sprieton/Feeder4pets/blueprint/Feeder4pets.pdf

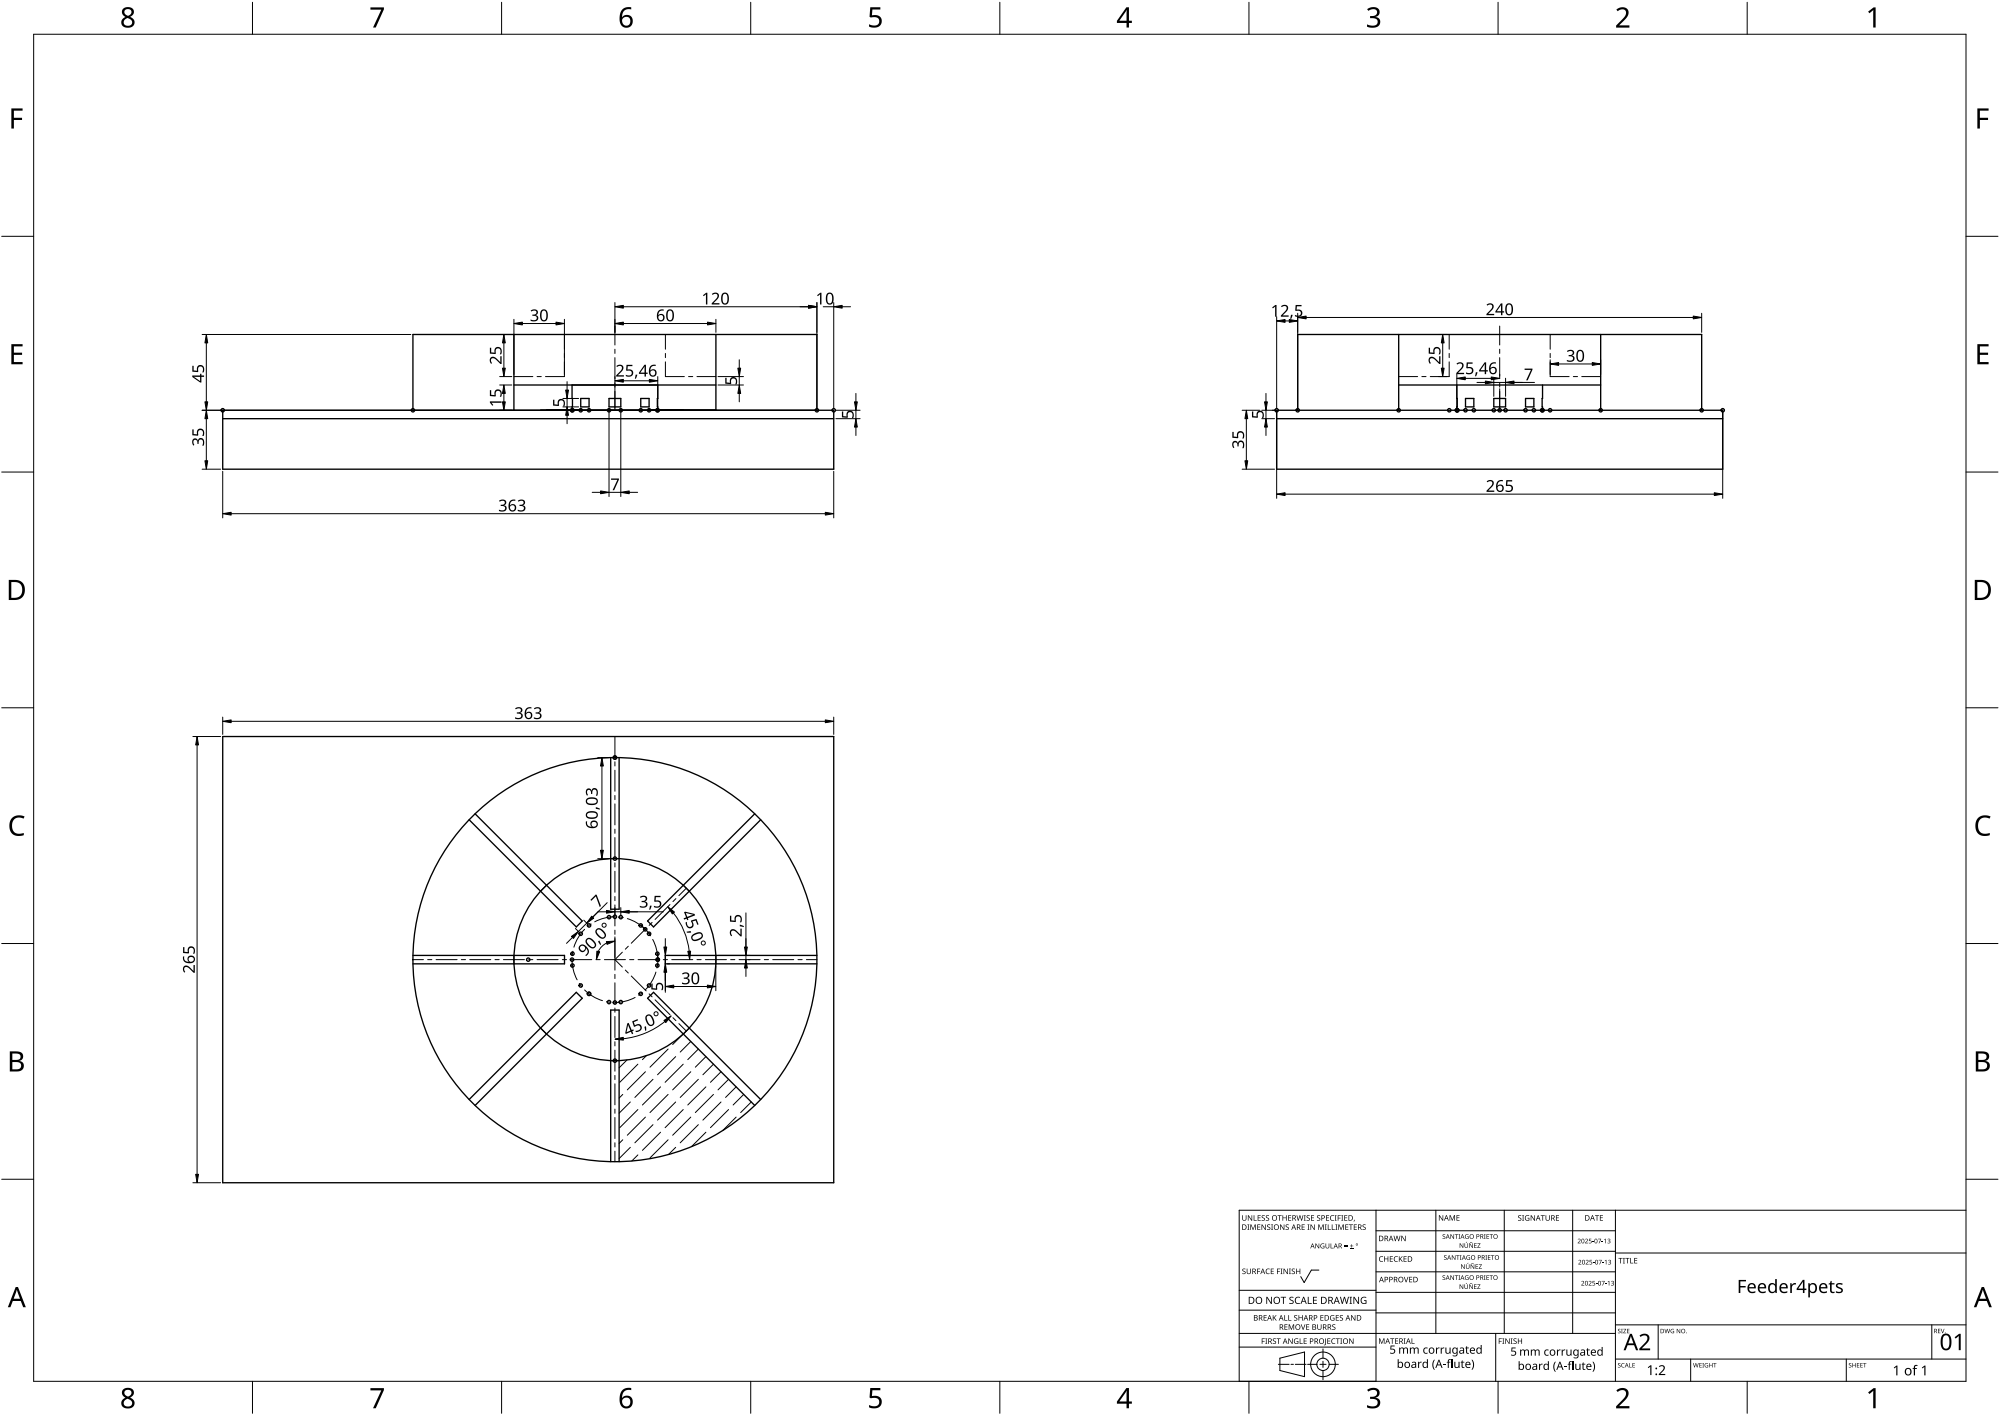
[picture p4: page 1]
