sprieton/Feeder4pets/(commit log)

2025-07-11 dispenser circuit
2025-07-11 Update README.md
    Added the circuit scheme
